aztlek/StarCitizen_6_ButtonBox/box/boxDesign.pdf

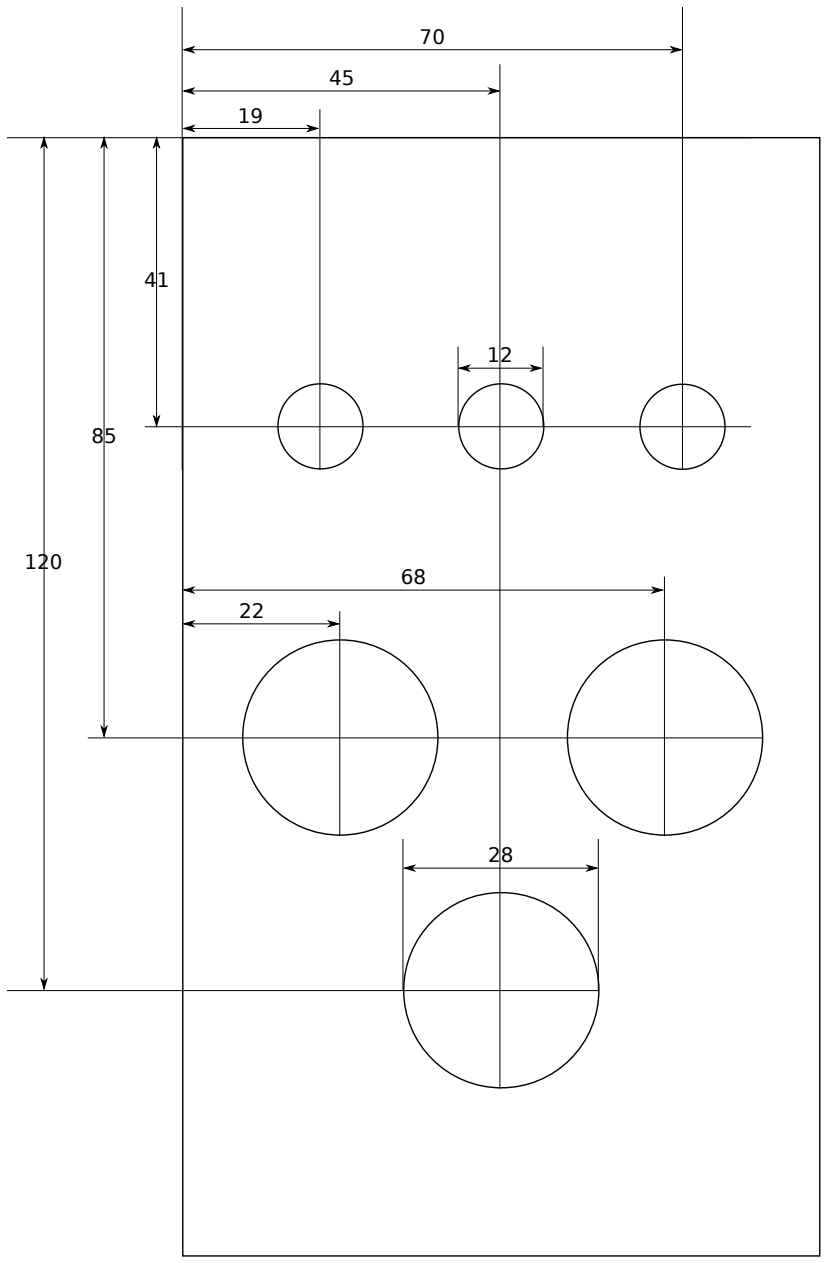
[picture p2: figure]
