aztlek/StarCitizen_6_ButtonBox/doc/images/boxDesign.png

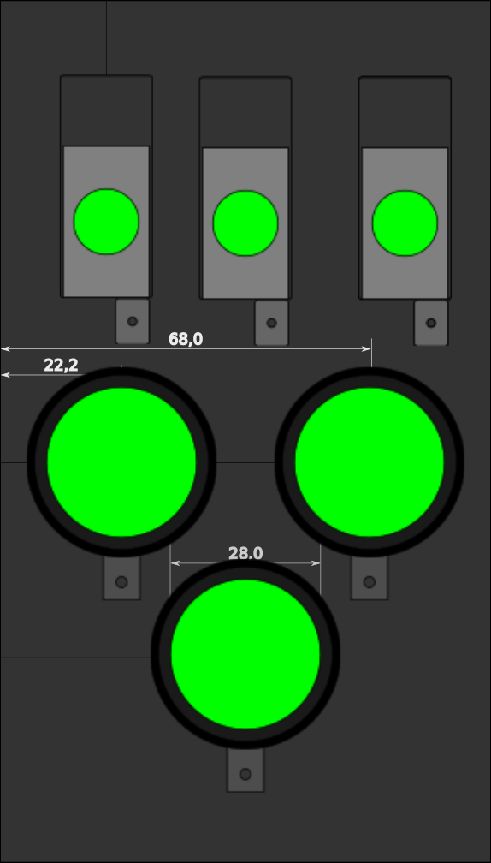
doc/images/boxDesign.png
