aztlek/StarCitizen_6_ButtonBox/doc/images/captura_joystick_jstest-gtk_debian.png

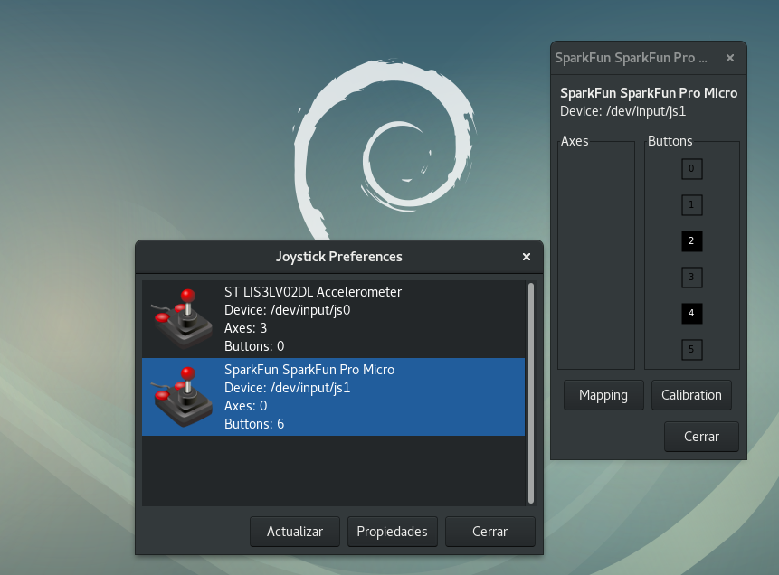
doc/images/captura_joystick_jstest-gtk_debian.png
