aztlek/StarCitizen_6_ButtonBox/doc/images/ConcaveButton-left-edited.png

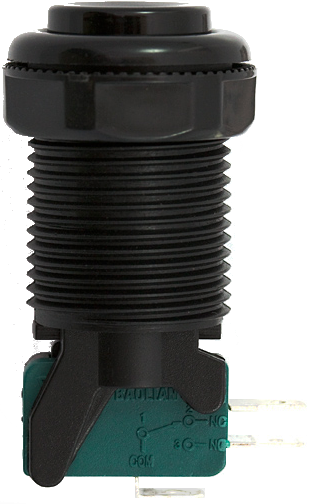
doc/images/ConcaveButton-left-edited.png
