aztlek/StarCitizen_6_ButtonBox/doc/images/ProMicro-top-edited.png

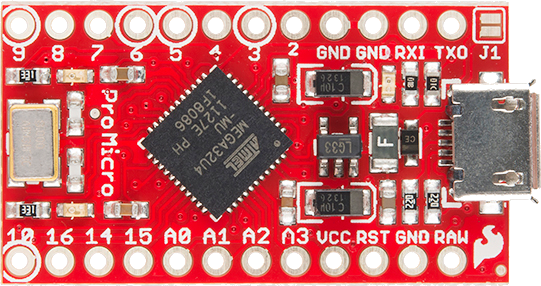
doc/images/ProMicro-top-edited.png
