aztlek/StarCitizen_6_ButtonBox/doc/images/ToggleSwitchAndCover-left-edited.png

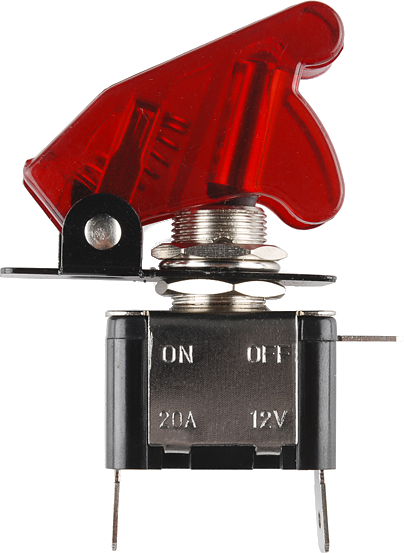
doc/images/ToggleSwitchAndCover-left-edited.png
