aztlek/StarCitizen_6_ButtonBox/doc/images/PlasticProjectBox_withoutMeasures.png

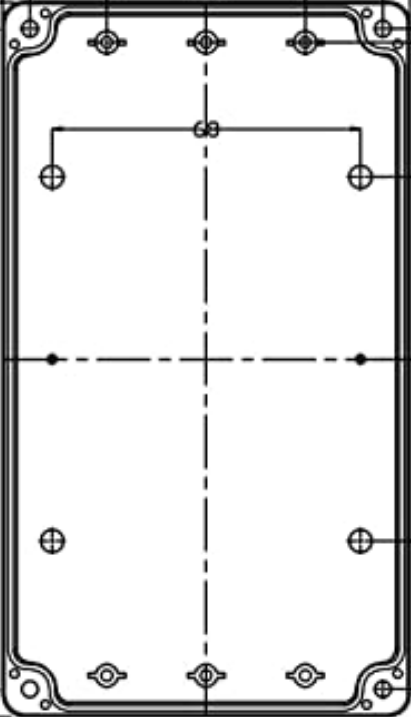
doc/images/PlasticProjectBox_withoutMeasures.png
