aztlek/StarCitizen_6_ButtonBox/(commit log)

2020-07-21 Added to the Spanish build guide "Open the code with the Arduino IDE"
2020-07-21 Added to the Spanish build guide how to install the Pro Micro in the Arduino IDE
